arco651749/CNC-DESIGN/output/v11/ADJUSTMENT_DESIGN.md

# v11 調整機構設計

v10 已定版。v11 = v10 加上調整機構：每一項組裝時要校的幾何關係，模型裡都有對應的量測基準和可微調、可鎖定的機構。

- 模型：`output/v11/CNC_v11.FCStd`（由 `freecad/v11/01_v11_adjusters.py` 從 v10 產生）
- 干涉檢查：`output/v11/logs/v11_motion.txt`
- 3D 導覽頁：`output/v11/CNC_adjusters_v11.html`（可切換校正工具組裝上／拆下）
- 動作模擬：`output/v11/CNC_motion_v11.html`（生產狀態，工具組已拆下）
- 校正流程：`output/v11/ALIGNMENT_PROCEDURE.md`（取代 v10 的 `ALIGNMENT_PLAN.md`）

## 1. 架構：三層，依序調整

Z 方向的「垂直度」其實是四個角度：Z 行程的前後傾、左右傾，主軸軸線的前後傾、左右傾。逐層的誤差累積估算（一般級滑塊、研磨底板）四項都超過 100 µrad 的目標，所以四項都要能調。

| 層 | 調什麼 | 機構 | 螺絲轉 10° | 調好後 |
|---|---|---|---|---|
| 1 | Z 行程前後傾，**左右腳座分開** | 腳座前凸緣下墊研磨薄鋼片；後方 10 mm 支點稜；可拆頂高螺絲抬起換片 | 每 0.01 mm 墊片 53 µrad | 腳座凸緣對基準底板配鉸 Ø8 銷 |
| 1 | X ⊥ Y | 腳座前方頂推塊，M6×0.75 一推一拉，柱距 640 | 33 µrad（X 走 300 變 0.010） | 同上 |
| 2 | Z 行程左右傾 | 滑座分鞍板＋Z 板；Z 板下方 Ø10 樞軸銷，上方 M6×0.5 對頂，力臂 430 | 32 µrad | Z 板對鞍板配鉸 Ø6 銷 |
| 3 | 主軸前後傾 | 三點支撐夾座，上方 1:20 斜楔，M5×0.5，力臂 69 | 10 µrad | **不打銷** |
| 3 | 主軸左右傾 | Ø8 樞軸銷在支點線上，左側 1:15 側向斜楔，力臂 69 | 13 µrad | **不打銷** |

為什麼這樣分層：

- **兩支立柱傾角不同造成的扭曲只能在第 1 層修。** X 線軌下游的機構只能做固定量的修正，修不掉隨 X 位置變化的誤差，所以左右腳座必須能分開調。
- **調整順序 1 → 2 → 3，後一層不會動到前一層。**
- **前兩層和主軸無關，調好後打銷鎖死。第 3 層跟著主軸走，不打銷**：主軸外殼對旋轉軸心的歪斜每支不同，換主軸就重調第 3 層。之後維修只准動第 3 層，就不會有人用主軸去掩蓋 Z 行程的誤差。

## 2. 可拆的校正工具組

調整機構裡，只負責「推」的零件都做成用螺絲鎖上的模組：鎖緊、打銷之後拆下，留著給下一台用。本身在承重的零件留在機上。
多台機並行生產時，一套工具組就能輪流校所有機台。

| 層 | 留在機上（承重或定位） | 可拆的工具組模組 | 拆下後由什麼保持 |
|---|---|---|---|
| 1 腳座前後傾 | 墊片 | 頂高螺絲（抬起凸緣換墊片），左右各一 | 墊片＋前後壓緊螺絲＋定位銷 |
| 1 轉向 | — | 推拉塊＋推、拉螺絲，左右各一 | 腳座螺絲＋定位銷 |
| 2 Z 板 | 樞軸銷 | 頂推塊＋頂推螺絲，左右各一 | 6 顆夾緊螺絲＋定位銷 |
| 3 主軸前後傾 | 鋼條、上方斜楔對、碟形彈簧 | 斜楔驅動座＋M5×0.5 螺絲（T 形頭勾住滑塊） | 螺栓預壓下的斜楔 |
| 3 主軸左右傾 | 樞軸銷 | 側向斜楔模組、右側跟隨塊 | 3 顆螺栓夾緊的摩擦力（約為螺栓頭扭矩的 18 倍） |

- 模型裡這 33 個零件歸在 `09 Alignment kit` 群組，屬性 `Kit = removable`。
- 3D 導覽頁可以切換「校正工具組 裝上／拆下」；動作模擬頁顯示的是拆下後的生產狀態。
- 拆下後機上只留螺絲孔，之後要重調（例如換主軸、撞機後）再把模組裝回去。
- 拆模組時鬆開的是推力，不是夾緊力，理論上不會動到設定；流程中仍規定拆完要複量一次。

## 3. X 軸為什麼沒有獨立的調整機構

X 軸的幾何關係都由其他地方決定：

| X 軸的關係 | 由哪裡調 |
|---|---|
| 兩支 X 線軌互相平行 | X 底板上的靠銷、偏心銷 |
| X ⊥ Y | 腳座推拉（第 1 層） |
| 兩支立柱傾角不同造成的 X 滑座側傾 | 左右腳座墊片分開調（第 1 層） |
| X 行程左右高低 | 不必調：治具板由機台自銑，板面必然平行於 X 運動，Z 的左右傾也對這個面調 |
| X 螺桿對 X 線軌平行 | 沒有調整機構（Y、Z 軸相同），靠支撐座與螺帽座的螺絲孔間隙，組裝時把滑座移到兩端再鎖緊 |

螺桿平行度不影響路徑精度，只影響螺桿壽命和順暢度。

## 4. 第 3 層：主軸三點支撐夾座

這是本版的重點。v11 第一版是「耳朵上四支頂高螺絲頂開一條縫」，審查算出鎖緊時鋁耳會被壓彎（耳朵每 1 kN 彎約 0.1 mm，整個調整縫只有 0.085 mm），四個螺絲尖也過拘束，所以整個重做。

**結構**

| 零件 | 說明 |
|---|---|
| `Spindle_clamp` | 6061-T6，156×86×88，Ø65 H7 孔在 (x0, y−13)。後面與孔同一次裝夾加工，後壁 6.5 mm。前方開口，2 支 M6 夾緊 |
| `Spindle_bar` | C45 研磨鋼條 160×8×12，前面磨 R100 弧面（頂點 z327）＝前後傾支點線；中段讓空 0.3，只在兩側凸耳下接觸 |
| `Spindle_nod_wedge_base` / `Spindle_nod_wedge` | 1.2510 淬硬 1:20 斜楔對，在 (x50, z396)，滑塊前面 R100 弧面。M5×0.5 螺絲從上方帶動，行程 ±5 = ±3.6 mrad |
| `Spindle_roll_pin` | Ø8 m6 淬硬銷，壓入滑板 12 mm、伸入夾座 6 mm（鼓形端），在 (x50, z327)：左右傾樞軸，正好在支點線上、斜楔正下方 |
| `Spindle_roll_wedge` | 1:15 淬硬側向斜楔，弧面頂在夾座左側面 z396，M5×0.5 從上方帶動，行程 ±4 = ±3.9 mrad |
| `Spindle_follower_screw` | 右側 M6×0.5 銅頭螺絲，把夾座頂向側向斜楔 |
| `Spindle_bolt_1..3` + `Spindle_disc_springs_1..3` | 3 顆 M6×50 從前面鎖，各自正對它壓的支撐點（B1、B2 在鋼條上，B3 在斜楔上）。每顆下方 4 片並聯 DIN 2093 A14 碟形彈簧，6 Nm |

**設計要點**

- **全程線接觸或面接觸，沒有任何東西站在螺絲尖上。**
- **前後傾在螺栓鎖到最終扭力之後才調。** 碟形彈簧讓斜楔在鎖緊狀態下仍推得動，調完就不再鎖任何東西，所以沒有「鎖緊後跑掉」。這是業界常被提到的問題（鎖緊後校正值跑掉，跑掉量和扭力成正比）。
- **斜楔的摩擦力沿 Z 方向穿過樞軸銷**，調前後傾不會帶動左右傾。
- **鋁夾座和鋼滑板的熱脹差**（20 K 時約 28 µm）由弧面線接觸處滑動吸收，角度不受影響。
- **主軸軸線往前移 13 mm**，夾座才能離開滑板 8 mm、後壁加厚到 6.5 mm。治具板跟著往前 13 mm，刀尖仍能走遍整塊板。

**估算的性能（未實測）**

| 項目 | v11 第一版 | 本版 |
|---|---|---|
| 解析度（每 10°） | 82 / 87 µrad | 10 / 13 µrad |
| 刀尖受 100 N 變位 | 2–5 µm，鎖緊會壓垮 | 約 2.7 µm（接觸剛性不確定度約 ±50%） |
| 鎖緊後偏移 | 會 | 前後傾無；左右傾估計 ≤ 2 µrad |

## 5. 第 1 層：腳座墊片與轉向推拉

- 腳座底面只有後方 y167..177 一條 10 mm 寬的支點稜，其餘讓空 0.5 mm。後方兩顆 M6 鎖在支點稜上，不會把腳座壓彎。
- 前凸緣底下墊一疊研磨薄鋼片，標準厚度 0.5 mm。U 形開口朝前，鬆開壓緊螺絲就能繞著螺絲塞進、抽出，不必拆螺絲。
- 墊片到支點稜約 190 mm：0.01 mm 墊片 ≈ 53 µrad ≈ Z 走 100 mm 差 0.005 mm。可抽掉全部 0.5 mm 或再加，範圍約 ±2.6 mrad。
- **量完直接算**：墊片要變多厚（mm）＝ 該支立柱的前後傾（每 100 mm 讀值）× 1.9。讀值為正（Z 往前倒）就加，為負就抽。通常一到兩次就到位。
- 換墊片時用一支 M8×1 頂高螺絲旋入凸緣、頂在基準底板的銅墊上，把前端抬起約 1 mm。它屬於校正工具組，墊好就退出來。
- 選墊片而不選斜楔的理由：面接觸、剛性最好，是業界最常用的做法；機上不留可動件；腳座也省掉斜面座的加工。代價是解析度一步 0.005/100，剛好等於每站目標，所以 0.005 mm 的墊片也要備著。
- 轉向推拉塊一推一拉：修正過頭時不必去推另一隻腳，龍門不會每修一次就往後走。

## 6. 其他修正

| 項目 | 修正 |
|---|---|
| 線軌側壓螺絲 | 移到靠銷正對面。原本壓在兩支銷中間，估算 200 N 就把主軌壓彎約 7 µm |
| 偏心銷 | 加止付螺絲鎖定 |
| X 水平頂高座 | 拿掉，X 底板靠治具定位後鎖緊 |
| 錶座 | 拿掉 Z 滑板左下角的偏心錶座（它讓 X 左端量不到）。錶改夾在筒夾裡，跟主軸同軸 |
| 治具板 | 往前 13 mm；改成先銑一次當量測基準、最後再銑一刀 |

## 7. 相對 v10 改了哪些零件

| 零件 | v10 | v11 |
|---|---|---|
| 腳座 | 80×180，被立柱整個蓋住 | 80×230，前凸緣 50，底面支點稜，凸緣下墊片 |
| 滑座 | 一塊 t30 | Z 板 t18＋鞍板 t12，總厚度不變 |
| 主軸夾座 | 96×81×70，主軸在 y0 | 156×86×88，主軸在 y−13 |
| 主軸本體、筒夾、刀具 | y0 | 往前 13 mm |
| X 底板、Z 板、Z 滑板、工作台、基準底板 | — | 只加孔 |

基準底板只加了孔，沒有銑槽或台階。

## 8. 量產前要用原型驗證

這套主軸調整機構沒有現成先例可對照：業界前後傾幾乎都靠墊片。下面的數字目前都是估算。

1. **主軸外殼對旋轉軸心的歪斜**：量 5 到 10 支（外殼放 V 枕、筒夾夾檢驗棒、轉外殼看平均偏移）。這個數字決定斜楔行程；目前用 0.05／100 估，設計 ±3.6 mrad 已留餘裕。可同時當進料驗收標準。
2. 刀尖剛性：100 N 對照「夾座直接鎖死」的基準，目標約 2.7 µm。
3. 鎖緊偏移：三種鎖緊順序各 10 次。
4. 反向空程：斜楔反向時估約 8 µrad。
5. 熱循環 20 次（冷機到 24k rpm 運轉 2 小時）後的漂移，並檢查接觸處有無磨損。
6. 撞機：0.5 kN、1 kN 推力；約 2 kN 以上夾座會在左右方向滑動，需要重調。
7. 三位沒受過訓練的技師計時，目標完整校正第 3 層 15 分鐘內。

## 9. 還沒做的

- v11 的應力應變分析（腳座支點稜加斜楔、滑座分兩片、新夾座）。
- 線軌與滑塊的一般鎖附螺絲孔（仍是設計評估階段）。
- 以 v11 的實際機構重做調校動畫。
