arco651749/CNC-DESIGN/output/v11/ALIGNMENT_PROCEDURE.md

# v11 校正流程

適用：`output/v11/CNC_v11.FCStd`。機構說明見 `output/v11/ADJUSTMENT_DESIGN.md`。
本文件取代 v10 的 `output/v10/ALIGNMENT_PLAN.md`，並修正獨立審查指出的問題：治具板太晚銑、偏心錶座讓 X 左端量不到、
檢驗棒行程不夠、鋁治具板吸不住磁性錶座、側壓螺絲壓彎主軌、翻轉法正負號未定義。

## 0. 原則

1. **錶永遠裝在主軸中心線上**：錶桿夾在 ER11 筒夾裡（Ø6 桿的槓桿錶座），錶跟著主軸走，X、Y 全行程都量得到。
2. **所有垂直度都對「銑過的治具板面」量。** 治具板是機台自己銑的，板面就是 X-Y 運動平面。
3. **治具板銑兩次**：龍門一鎖上就先銑一次當基準（銑削時 Z 固定、只走 X-Y，結果和龍門傾斜無關）；第 1、2 層調完再銑最後一刀。
4. **三層依序調：龍門腳座 → Z 板 → 主軸夾座。** 後一層不會動到前一層。前兩層調好打銷；主軸夾座不打銷。
5. 治具板是鋁的，磁性錶座吸不住。需要錶座固定在工作台時，用 T 槽壓板夾住錶座，或把治具板拆下吸在鋼工作台上。
6. 每個量測值都記在第 9 節的紀錄表。
7. **只負責推的零件是可拆的校正工具組**：每一層鎖緊、打銷、複量合格後拆下，拆完再量一次；工具組留給下一台用。

### 翻轉法的正負號

讀值定義：走完量測長度 L 後的讀值減起點讀值，錶被壓進去為正，再除以 L，得到斜率 m。
基準件在位置 1 量得 m1，翻轉 180° 後量得 m2，兩次都走同一方向：

- 機台誤差 = (m1 + m2) / 2
- 基準件誤差 = (m1 − m2) / 2

花崗石直角尺：沿 A 邊翻面，重新把 A 邊對齊 Y，再讀 B 邊。圓柱直角尺：繞自己的軸轉 180°，從同一側讀。

## 1. 工具

| 工具 | 規格 | 用途 |
|---|---|---|
| 槓桿式千分錶 2 支 | 0.001–0.002 mm | 所有量測 |
| 筒夾錶座 | Ø6 桿，夾在 ER11，錶尖可調到距軸心 100 mm | 錶裝在主軸中心線上 |
| 花崗石直角尺 | 300×200 以上，00 級 | X ⊥ Y |
| 圓柱直角尺 | Ø80×150，00 級 | Z 行程前後、左右傾 |
| 花崗石平尺 | 500 mm | 主軌直線度（必檢） |
| 跨橋量具（自製） | 鋼塊騎在主軌上，錶碰副軌 | 兩軌平行 |
| ER11 檢驗棒 | Ø6–7，露出約 80 mm | 主軸偏擺、最終閉合檢查 |
| V 枕一對 | — | 主軸進料檢驗 |
| 扭力扳手 | 1–10 N·m 及 M8 範圍 | 定扭力鎖附 |
| 長柄六角扳手 | 2.5 mm（M5 斜楔螺絲） | 小角度微調 |
| 研磨薄鋼片 | 0.005、0.01、0.02、0.05、0.1、0.3 mm，U 形開口 | 腳座前後傾 |
| 手提鉸刀與鑽模襯套 | Ø6、Ø8 H7 | 配鉸定位銷 |
| 花崗石平台 | 至少 800×500 | 龍門次組立（龍門寬 720，630 的平台放不下）；沒有的話龍門直接在機台上組 |

驗收時建議租用循圓測試儀，或用試切件送三次元。

## 2. 進料檢驗

1. 立柱兩端面：銑削，對側面垂直度 ≤ 0.02/160。
2. **主軸外殼對旋轉軸心**：外殼放 V 枕，筒夾夾檢驗棒，千分錶碰檢驗棒的近端和遠端；轉動整支外殼一圈，記下兩點的平均偏移，兩者之差除以距離就是夾角。前 5–10 支的結果用來確認斜楔行程，之後當驗收標準。
3. 夾座：Ø65 孔與後面的垂直度、夾座後面平面度。

## 3. 組裝與線軌（零件平放時做）

每支線軌都一樣：

1. 主軌靠 3 支靠銷，正對靠銷的側壓螺絲壓住；螺絲由中間往兩端、分兩輪鎖到定扭力。
2. **主軌直線度（必檢）**：平尺放在主軌旁，或錶沿主軌側面滑全長，≤ 0.005。超差先查靠銷與側壓螺絲，不要往下做。
3. 副軌輕鎖。跨橋量具騎在主軌上，錶碰副軌側面，滑全長；轉偏心銷到讀值變化 ≤ 0.005，鎖緊副軌，偏心銷用止付螺絲鎖住。
4. 裝螺桿：螺帽座移到靠近固定側支撐座的位置再鎖緊；全行程看伺服負載率是否平穩。

順序：

- X 線軌在 X 底板上機之前裝好。
- **Z 線軌在裝 Z 滑板之前調好**：裝上滑板後，部分偏心銷和側壓螺絲會被蓋住。
- Y 線軌在工作台底面，工作台翻面時做。
- Y 滑塊：主側兩顆靠基準底板上的靠銷鎖緊，副側兩顆浮動；裝上工作台，手推全行程數次，在行程中段鎖緊副側。

## 4. 龍門上機與治具板第一次銑削

1. 腳座先鎖在立柱底端，X 底板用治具定位在兩支立柱背面並鎖緊。
2. 龍門放上基準底板。兩個腳座凸緣下先墊標準厚度 0.5 mm 的墊片，腳座螺絲上到貼合即可。
3. 鎖上治具板（比 v10 往前 13 mm）。
4. **第一次銑削**：機台把治具板輕銑一刀，0.1 mm。

## 5. 第 1 層：龍門腳座

### 5.1 X ⊥ Y（轉向）

1. 直角尺平放在治具板上。
2. 錶碰 A 邊，走 Y；輕敲直角尺到全程讀值不變。
3. 錶改碰 B 邊，走 X 280 mm，記下 m1。
4. 直角尺翻面，重做 2、3，記下 m2。機台誤差 = (m1 + m2)/2。
5. 鬆開腳座的壓緊螺絲，用腳座前方的推拉螺絲一退一進，把一支立柱往前或往後移。螺絲轉 10°，X 走 300 mm 約變 0.010 mm。
6. 目標 ≤ 0.010/300。

### 5.2 Z 行程前後傾（左右腳座分開）

1. 圓柱直角尺立在治具板上，錶從筒夾伸出約 100 mm，碰圓柱朝後的一面。
2. X = −150 時走 Z 100 mm，讀值 e₋；X = +150 時再走一次，讀值 e₊。
3. 兩支立柱的傾角（每 100 mm）：
   - 左柱 L = (0.734·e₋ − 0.266·e₊) / 0.468
   - 右柱 R = (0.734·e₊ − 0.266·e₋) / 0.468

   推導：立柱在 x = ±320，X = −150 處的傾斜是兩柱的線性內插，e₋ = 0.734·L + 0.266·R；X = +150 處 e₊ = 0.266·L + 0.734·R。
4. **算墊片**：墊片要變多厚（mm）＝ 該柱傾角（每 100 mm 讀值）× 1.9。讀值為正代表 Z 往前倒（往上走時錶被壓進去），要加墊片；為負就抽掉。例：L = +0.008/100 → 左腳座加 0.015 mm。
   1.9 是墊片位置到後方支點稜的距離（約 190 mm）除以 100；0.01 mm 墊片約 0.005/100。
5. **換墊片**：鬆開該腳座**後方支點稜上的兩顆 M6** 和前方壓緊螺絲，頂高螺絲旋入凸緣把前端抬起約 1 mm，換墊片，退出頂高螺絲，依序鎖回。
6. 重量 e₋、e₊。通常一到兩次就到位。
7. 目標：兩站各 ≤ 0.005/100，**兩站之差 ≤ 0.005/100**。兩站之差代表兩支立柱傾角不同，會扭 X 底板，造成滑座側傾。

### 5.3 鎖緊、複量、打銷

1. 依序鎖緊：後方支點稜 M6 → 前方壓緊 M8 → 推拉螺絲對鎖。
2. 重做 5.1、5.2。鎖緊常會讓數值跑掉，合格值必須是鎖緊後量到的。
3. 合格後，兩個腳座凸緣各與基準底板配鉸一支 Ø8 定位銷。
4. 打銷後再量一次並記錄。
5. 拆下工具組：兩個推拉塊（連同推、拉螺絲）。頂高螺絲在換完墊片時就已退出。墊片留在原位。拆完重做 5.1、5.2 一次，確認沒有變化。

## 6. 第 2 層：Z 板（Z 行程左右傾）

1. 圓柱直角尺立在治具板上，錶碰圓柱的側面，走 Z 100 mm，讀值記 m1；圓柱轉 180° 再量 m2，取 (m1 + m2)/2。
2. 鬆開 Z 板的 6 顆夾緊螺絲，鞍板上兩支頂推螺絲一退一進，Z 板繞下方樞軸銷轉動。螺絲轉 10° 約變 0.003/100。
3. 目標 ≤ 0.005/100（上限 0.010）。
4. 鎖緊夾緊螺絲，兩支頂推螺絲對鎖，複量。合格後 Z 板與鞍板配鉸一支 Ø6 定位銷，再量一次並記錄。
5. 拆下兩側的頂推塊（連同螺絲），再量一次。

### 治具板最後一刀

第 1 層的調整改變了 X 運動平面，所以在進入第 3 層之前，治具板再銑一刀。

## 7. 第 3 層：主軸夾座

量法：錶桿夾在筒夾裡，錶尖距軸心 100 mm，碰治具板。手轉主軸，在前、後、左、右四點讀值。

- 前後傾 = (前 − 後) / 200
- 左右傾 = (左 − 右) / 200
- 目標：兩方向的讀值差各 ≤ 0.010（等於 50 µrad）。0.002 的錶可分辨約 10 µrad。

步驟：

1. 主軸夾緊螺絲先鎖到固定扭力。夾緊力不均會改變主軸角度，所以一定要在調整前夾好。
2. 兩個斜楔放在中間刻線；夾座掛上樞軸銷，3 顆螺栓鎖到 1 N·m。
3. 掃四點，記錄。
4. **左右傾**：右側跟隨螺絲退 1/4 圈，轉左側側向斜楔的螺絲（每 10° 約 13 µrad）。要往反方向修時，先用跟隨螺絲推過頭，再用斜楔推回來，讓最後一步永遠是「斜楔推進」。跟隨螺絲靠上，0.3 N·m。
5. 3 顆螺栓鎖到最終的 6 N·m。
6. **前後傾**：在最終扭力下直接轉上方斜楔螺絲（每 10° 約 10 µrad；一圈約讓前後讀值差變 0.072）。碟形彈簧會跟著，不必鬆螺栓。最後一步要往「斜楔推進」的方向結束。
7. 重掃四點並記錄。
8. 拆下工具組：左側側向斜楔模組、右側跟隨塊、上方斜楔的驅動座（連同螺絲）。上方斜楔對留在原位。拆完重掃四點，確認沒有變化。
9. 之後若因任何原因重鎖螺栓，就要把工具組裝回去重調。

**換主軸時只重做本節**：裝回主軸那一組工具組，調完再拆。前兩層不用動。目標 15 分鐘內完成。

## 8. 驗收

1. **扭曲檢查**：X = −150 與 +150 各做一次前後掃描，兩者之差 ≤ 0.010。
2. **閉合檢查**：拆下治具板。檢驗棒露出 80 mm，錶座用 T 槽壓板固定在工作台上，錶碰檢驗棒，走 Z 60 mm（裸台時刀尖到台面約有 62 mm 行程）。X 向、Y 向各一次，每次主軸轉 180° 再量一次取平均，扣掉檢驗棒本身的偏擺。讀值是「主軸軸線與 Z 行程」的夾角，目標 ≤ 0.006/60，並應和第 5–7 節的結果吻合。
3. 重複定位：錶頂住擋塊，同方向靠近 10 次，散佈 ≤ 0.005；再量反向靠近的差值（背隙）。
4. 循圓測試或試切件。

這一步可以看出有沒有人用主軸層去掩蓋 Z 行程的誤差：掃描會好看，但閉合檢查會不合格。

## 9. 紀錄表

| 項目 | 量測長度 | 目標 (mm) | 實測 | 判定 |
|---|---|---|---|---|
| 主軌直線度（X/Y/Z） | 全長 | 0.005 | | |
| 兩軌平行（X/Y/Z） | 全長 | 0.005 | | |
| X ⊥ Y（翻轉平均） | 280 | 0.010/300 | | |
| Z 前後傾，X = −150 / +150 | 100 | 0.005 | | |
| 兩站之差 | 100 | 0.005 | | |
| Z 左右傾（翻轉平均） | 100 | 0.005（上限 0.010） | | |
| 主軸掃描，前後 / 左右 | R100 | 0.010 | | |
| 扭曲檢查（X = ±150 前後掃描之差） | R100 | 0.010 | | |
| 閉合檢查（X 向 / Y 向） | 60 | 0.006 | | |
| 重複定位（X/Y/Z） | — | 0.005 | | |
| 背隙（X/Y/Z） | — | 記錄 | | |
| 主軸外殼對軸心（進料） | — | 待定 | | |
| 循圓或試切件 | — | 記錄 | | |

目標值是把 ±0.02 mm 的路徑精度大約留一半給幾何誤差所推出來的建議值，首台實測後可以再調整。
