arco651749/CNC-DESIGN/output/v4/V4_NOTES.md

# v4 設計（由 v3 r7 衍生，r7 定稿不動）

產生：`freecadcmd freecad/v4/01_v4_through_slot_x.py`（讀 `output/v3/CNC_v3_r7.FCStd` → `output/v4/CNC_v4.FCStd`），
檢查：`freecadcmd freecad/v4/02_motion_check_v4.py` → `output/v4/logs/v4_motion.txt`（靜態全零件兩兩比對＋18 姿態：無碰撞）、`v4_clear.txt`。

## 與 r7 的差異
- **X 軸穿槽傳動**：X 螺桿、螺帽、C-TEK12、馬達都在 X 底板**後面**；底板開長槽 347×60，**螺帽座（CNC 塊）包住滾珠螺帽本體、外形同法蘭寬（52）**，法蘭鎖在螺帽座端面，螺帽座穿過長槽鎖到前面 X 滑座背面。前面只有 X 線軌。
- **X 底板 t20（720×160）當龍門橫樑**，鎖在兩支立柱的**後面**（整面鎖附）；取消鋁擠橫樑 ×2 與接合板。
- **X 滑座直接鎖滑塊**，取消 30 mm 墊條；X 線軌改 SX2RNL28-540（放進兩柱之間），主軸位置不變。
- **立柱前移**到 y 2–162（前緣到後排 Y 滑塊），間距 ±280（避開 X 滑座掃過 ±270），HFS8-80160-472。
- **X 馬達直結**（CPJC40 聯軸器）：馬達在螺桿延長線上、底板後面。軸心離底板 25、馬達半寬 30，所以底板後面在馬達段銑 **7 mm 定位凹槽**，Z 式馬達座嵌入凹槽、4×M6 鎖附（與 C-TEK12 同一面）。機寬約 768。
- **X 螺桿** C-KBS1505-395（固定－自由，軸心在底板後 25）。
- **基準板 t20、720×327**（r7：t30、640×512）。
- **驅動器**移到 X 底板後方的電控板（兩支撐柱，避開螺帽行程）。
- **三軸螺帽座都是包住螺帽的 CNC 塊**（外形同法蘭寬，法蘭鎖在端面）：X 穿過長槽鎖 X 滑座背面；Y 底面鎖基準板（Y 螺帽往後 26，讓座子完整落在基準板上）；Z 鎖主軸滑板背面。
- **三軸馬達座都挖 Ø50 H7 通孔**＝HG-KR43／43B 止口 Ø50×3（由三菱原廠 STEP 量得），馬達止口插入對心，聯軸器 Ø40 從同一孔穿過；取消原本 Ø44 孔＋Ø50 淺沉孔的兩段式做法。
- **三支螺桿端部加工**：螺紋 Ø16 直到 C-TEK12 端面 → Ø12×36（軸承＋鎖緊螺帽，在支撐座內）→ Ø10×27（插聯軸器 24.5，聯軸器 CPJC40-RD-10-14）。取消 v3 沿用的獨立「假軸頸」。
  - Y：C-KBS1505-538（螺紋 −305～170），X：C-KBS1505-458，Z：C-KBS1505-393。
  - 螺帽全行程都在螺紋上：Y 上料位置餘量 23、送入端 10；X 兩端 24／29。（修正：上一版 Y 上料時螺帽會跑出螺紋 29 mm；r7 也有 3 mm 跑出，r7 定稿未改。）
- Y、Z 其餘同 r7。

## 間隙（`v4_clear.txt`）
X 滑座↔立柱 10、螺帽座↔長槽 4、馬達↔凹槽底 2、工作台↔立柱 60、Y 馬達↔基準板 15、工作台↔Y 螺帽座 2.4、Z 螺帽座↔X 滑座 2.4。

## 待確認
- t20 底板開槽後的剛性（FEA）、長槽擋屑（不鏽鋼擋屑帶／伸縮護罩）。
- 電控板固定方式。
