arco651749/CNC-DESIGN/output/v3/R7_FINAL.md

# v3 → r7 修改紀錄（r7 定稿 2026-11-13）

**r7（最新）**：拿掉 X 軸浮動支撐座 C-TEF12，三軸螺桿都改成固定－自由。X 危險轉速（Ø15、L≈450）約 2100 rpm，打 8 折約 1680 rpm，大於 100 mm/s 所需的 1200 rpm。`freecad/revisions/08_r7_remove_x_float_support.py` → `output/v3/CNC_v3_r7.FCStd`、`output/v3/CNC_motion_r7.html`。
Y 軸前方那組是**固定滾珠螺帽＋螺帽座**（倒裝螺桿的驅動點），不是支撐座，保留。

由 `freecad/revisions/01..07` 從 `output/v3/CNC_v3.FCStd` 依序產生（`bash freecad/revisions/run_all.sh`）。
r6 重跑結果與互動修改版一致；三軸行程兩端＋中間 18 個姿態干涉檢查：無碰撞（`output/v3/logs/r6_motion.txt`）。

## 設計原則
- 馬達座、支撐座（C-TEK12）、線軌鎖在**同一個基準面**（單面加工、單面鎖附）。
- 三軸馬達座同一種做法：方塊加厚到支撐座旁，鎖在該軸基準面；軸心離基準面只有 25 mm（C-TEK12 中心高），
  60 方馬達靠基準面那側的兩顆螺孔落在面上，所以方塊帶一道**後唇**承接（Z 搭滑座板頂面、X 靠 X 軌板端面、Y 貼工作台後端面）。
- 螺桿端聯軸器露在座外；馬達端聯軸器先鎖在馬達軸上，再整組從 Ø44 孔插入。

## 各軸
| 軸 | 馬達座鎖在 | 後唇靠 | 同一面上的零件 |
|---|---|---|---|
| Z | 滑座板正面（4×M6 由前往後） | 滑座板頂面 | Z 線軌、C-TEK12 |
| X | X 軌板正面（4×M6 由前往後） | X 軌板端面 | X 線軌、C-TEK12 |
| Y | 工作台底面（4×M6 由下往上） | 工作台後端面 | C-HLG45 滑軌、C-TEK12 |

## BOM 變更（相對 v3）
| 項目 | v3 | r6 |
|---|---|---|
| Y 線軌 | SE2RZ42-680 ＋ 墊高條 t16 ×2 | **三住 C-HLG45**（H=70）滑軌 L700 ×2、滑塊 ×4，取消墊高條 |
| 工作台 | 440×420×40 | **440×473.5×40**（後端加長 53.5） |
| 龍門立柱 | HFS8-80160-300 | **HFS8-80160-312**（Y 墊高 12，淨空不變） |
| X 螺桿 | C-KBS1505-540 | **C-KBS1505-517.5**（支撐座內移 22.5） |
| X 滑座板 | 240×380×30 | **240×438×30**，整組 Z 軸上移 100 |
| 基準板 | 690×595×30 | **640×512×30** |
| 馬達座 | X/Y/Z 原支架 | X/Y/Z 方塊（自製），Y 馬達座跟著工作台移動 |
| Y 螺帽座 | 高 54 | 高 66 |
| X 浮動支撐座 | C-TEF12 | **取消**（r7，固定－自由） |

## 尺寸
- 機寬 775（v3 798）；Z 軸底座底部 z272（離工作台面 162）；Z 馬達頂 z861。
- Y 馬達底部離基準板 15 mm；滑塊離軌道末端 10.5 mm（Y 兩端）。

## 待辦
- HFS8-80160-312、C-KBS1505-517.5 目前由舊長度模型接長／截短，待換原廠 STEP。
- 主軸懸伸增加 100（Z 軸上移），刀尖剛性待 FEA 確認。
- C-HLG45 滑塊螺孔朝下：先把滑塊鎖到基準板，再裝上床身。

## 檔案
- `output/v3/CNC_v3_r6.FCStd`：r6 組立（r2–r5、`_fix` 為中間版）
- `output/v3/CNC_motion_r6.html`：3D 動作模擬（單檔、可離線開）
- `output/v3/r6_renders/`：特寫圖
