arco651749/CNC-DESIGN/output/CNC_Gantry.step

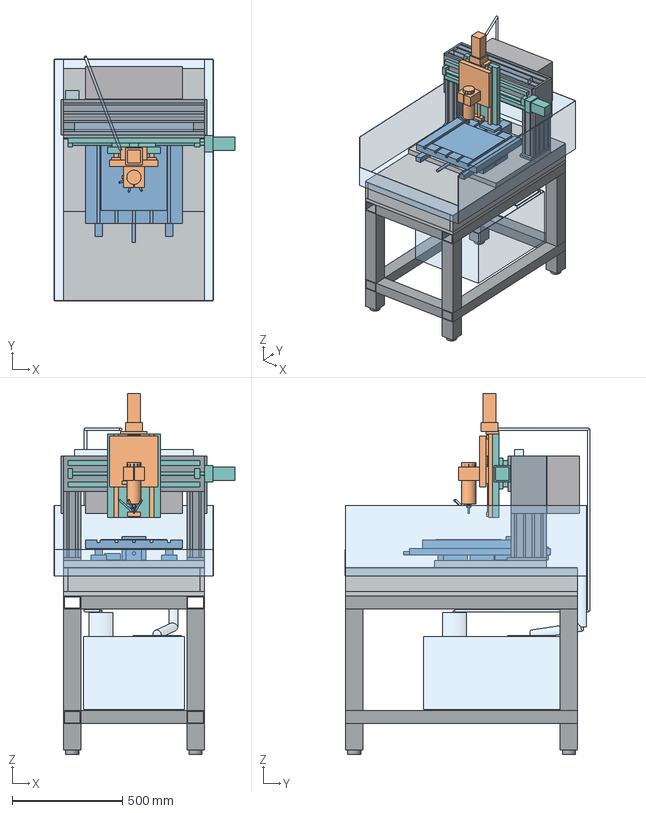
[picture p1: CAD file, 2026-11-12]
output/CNC_Gantry.step
820.1 x 1113.0 x 1639.0 mm
Stand_leg_1
Stand_leg_2
Stand_leg_3
Stand_leg_4
Stand_top_L
Stand_top_R
Stand_top_F
Stand_top_B
Stand_low_L
Stand_low_R
Stand_low_F
Stand_low_B
Leveling_foot_1
Leveling_foot_2
Leveling_foot_3
Leveling_foot_4
Datum_base_plate
Bed_floor_sheet
Bed_bottom_plate
Bed_long_web_1
Bed_long_web_2
Bed_long_web_3
Bed_long_web_4
Bed_cross_rib_1
Bed_cross_rib_2
Bed_cross_rib_3
Bed_cross_rib_4
Bed_cross_rib_5
Y_rail_L
Y_block_L1
Y_block_L2
Y_rail_R
Y_block_R1
Y_block_R2
Y_ballscrew
Y_nut_housing
Y_motor_bracket
Y_motor_adapter
Y_coupling
Y_motor
Y_drag_chain
Work_table
Work_area_300x300
Column_foot_L
Gantry_column_L
Gantry_joint_plate_L
Column_foot_R
Gantry_column_R
Gantry_joint_plate_R
Gantry_beam_1
Gantry_beam_2
X_rail_plate
X_rail_1
X_block_11
X_block_12
X_rail_2
X_block_21
X_block_22
X_ballscrew
X_BK_support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
