arco651749/CNC-DESIGN/output/core/CNC_Core.step

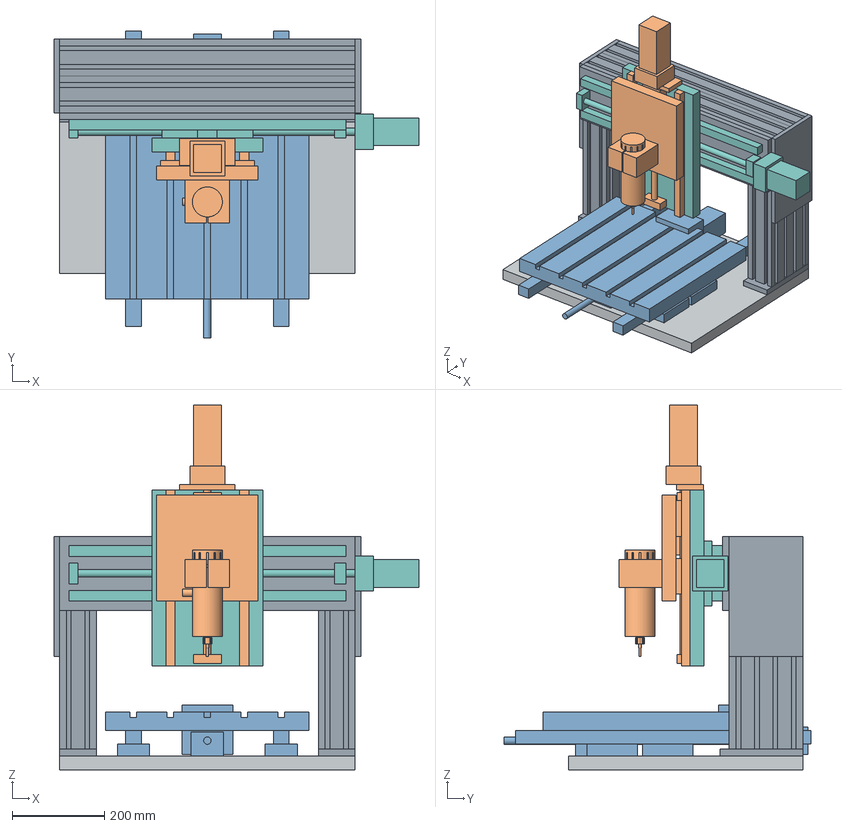
[picture p2: CAD file, 2026-11-12]
output/core/CNC_Core.step
790.0 x 665.5 x 789.0 mm
Datum_base_plate
Y_rail_L
Y_block_L1
Y_block_L2
Y_rail_R
Y_block_R1
Y_block_R2
Y_ballscrew
Y_nut_housing
Y_motor_bracket
Y_motor_adapter
Y_coupling
Y_motor
Work_table
Column_foot_L
Gantry_column_L
Gantry_joint_plate_L
Column_foot_R
Gantry_column_R
Gantry_joint_plate_R
Gantry_beam_1
Gantry_beam_2
X_rail_plate
X_rail_1
X_block_11
X_block_12
X_rail_2
X_block_21
X_block_22
X_ballscrew
X_BK_support
X_BF_support
X_motor_mount
X_coupling
X_motor
X_carriage_plate
X_nut_housing
Z_rail_L
Z_rail_R
Z_slide_plate
Z_block_L1
Z_block_L2
Z_block_R1
Z_block_R2
Z_ballscrew
Z_nut_housing
Z_BF_support
Z_BK_support
Z_motor_base
Z_motor_mount
Z_coupling
Z_motor
Spindle
Spindle_fan_cover
Spindle_connector
Spindle_nose
ER11_collet
ER11_nut
Tool_D5
Spindle_clamp
