arco651749/CNC-DESIGN/output/v1/CNC_Gantry_v1.FCStd

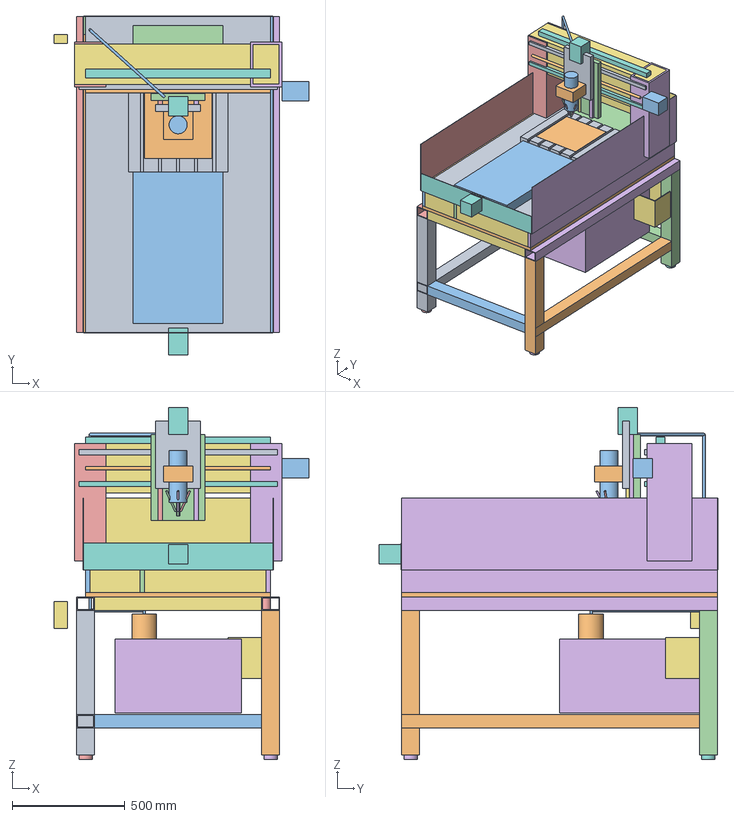
[picture p3: CAD file, 2026-11-12, an earlier design]
output/v1/CNC_Gantry_v1.FCStd
1130.0 x 1502.0 x 1560.0 mm
Stand_leg_1
Stand_leg_2
Stand_leg_3
Stand_leg_4
Stand_top_L
Stand_top_R
Stand_top_F
Stand_top_B
Stand_low_L
Stand_low_R
Stand_low_F
Stand_low_B
Leveling_foot_1
Leveling_foot_2
Leveling_foot_3
Leveling_foot_4
Bed_top_plate
Bed_bottom_plate
Bed_long_web_1
Bed_long_web_2
Bed_long_web_3
Bed_long_web_4
Bed_cross_rib_1
Bed_cross_rib_2
Bed_cross_rib_3
Bed_cross_rib_4
Bed_cross_rib_5
Bed_cross_rib_6
Bed_cross_rib_7
Y_rail_L
Y_block_L1
Y_block_L2
Y_rail_R
Y_block_R1
Y_block_R2
Y_ballscrew
Y_nut_housing
Y_BK_support
Y_BF_support
Y_motor
Work_table
Work_area_300x300
Y_bellows_front
Y_bellows_rear
Gantry_column_L
Gantry_column_R
Gantry_beam
X_rail_1
X_rail_2
X_ballscrew
X_motor
X_carriage_plate
Z_rail_L
Z_rail_R
Z_ballscrew
Z_motor
Z_slide_plate
Spindle_clamp
Spindle
Tool_ER20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
