arco651749/CNC-DESIGN/output/v10/fea/x_base_plate.step

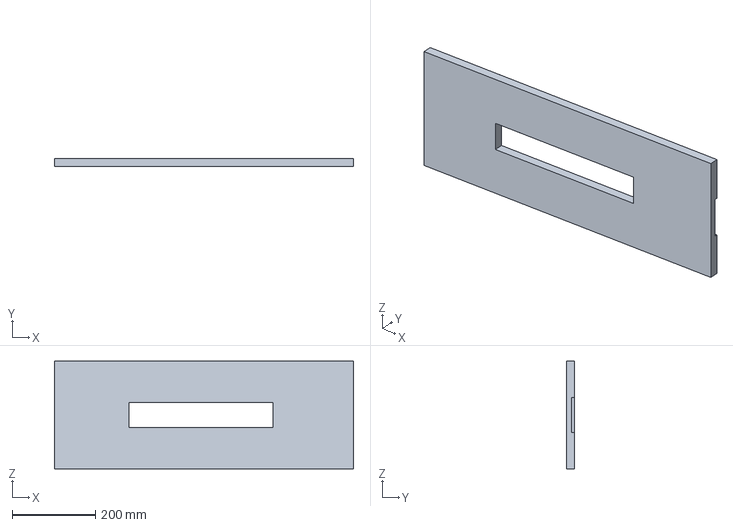
[picture p4: CAD file, 2026-11-13, an earlier design]
output/v10/fea/x_base_plate.step
720.0 x 20.0 x 260.0 mm
