arco651749/CNC-DESIGN/output/v3/CNC_v3-AP214.step

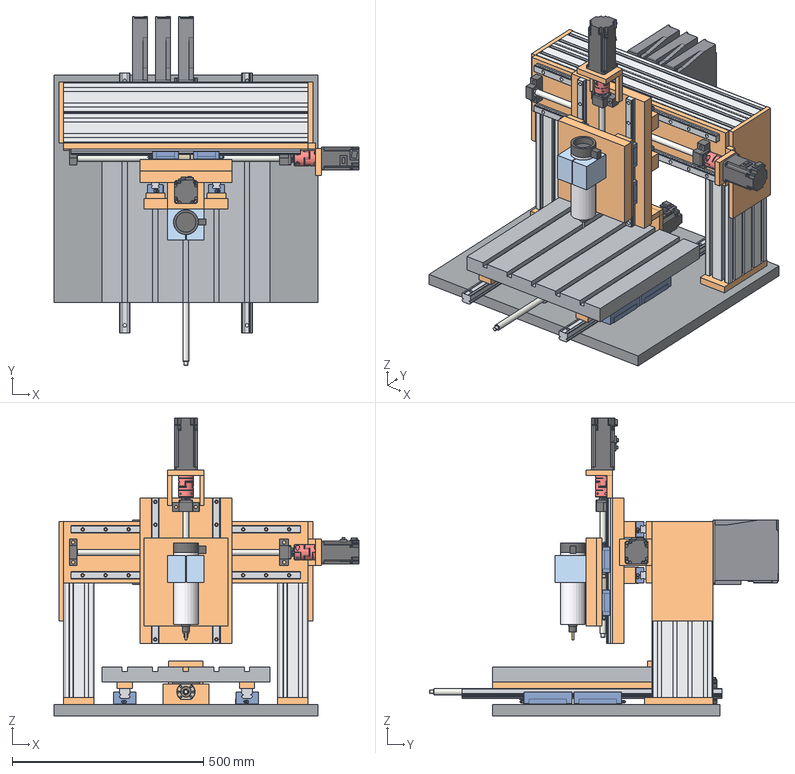
[picture p5: CAD file, 2026-11-13, an earlier design]
output/v3/CNC_v3-AP214.step
797.8 x 913.2 x 779.1 mm
Datum_base_plate
Y_rail_L
Y_block_L1
Y_block_L2
Y_carrier_bar_L
Y_rail_R
Y_block_R1
Y_block_R2
Y_carrier_bar_R
Work_table
Y_ballscrew
Y_ball_nut
Y_nut_bracket
Y_support_fixed
Y_journal
Y_coupling
Y_motor
Y_motor_bracket
Column_foot_L
Gantry_column_L
Gantry_joint_plate_L
Column_foot_R
Gantry_column_R
Gantry_joint_plate_R
Gantry_beam_1
Gantry_beam_2
X_rail_plate
X_rail_1
X_block_11
X_block_12
X_spacer_1
X_rail_2
X_block_21
X_block_22
X_spacer_2
X_carriage_plate
X_ballscrew
X_ball_nut
X_nut_bracket
X_support_fixed
X_support_float
X_journal
X_coupling
X_motor
X_motor_bracket
Z_rail_L
Z_block_L1
Z_block_L2
Z_spacer_L
Z_rail_R
Z_block_R1
Z_block_R2
Z_spacer_R
Z_slide_plate
Z_ballscrew
Z_ball_nut
Z_support_fixed
Z_journal
Z_coupling
Z_motor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
