arco651749/CNC-DESIGN/output/v4/CNC_v4.FCStd

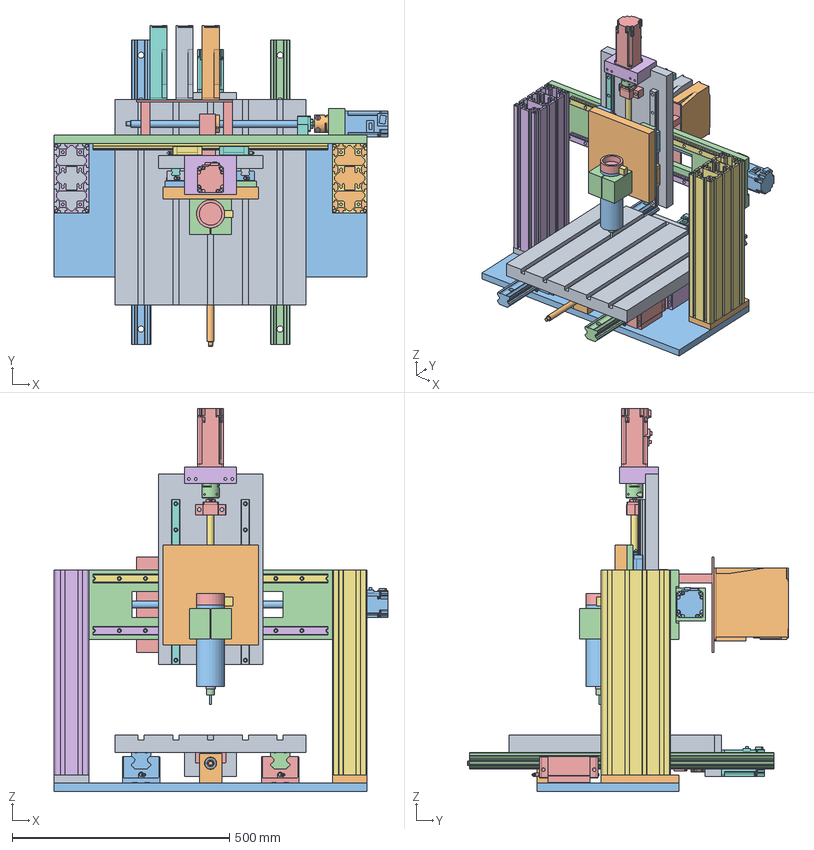
[picture p6: CAD file, 2026-11-13, an earlier design]
output/v4/CNC_v4.FCStd
767.8 x 738.2 x 881.1 mm
Column_foot_L
Column_foot_R
Datum_base_plate
ER11_nut
Electrical_panel
Gantry_column_L
Gantry_column_R
Servo_amp_X
Servo_amp_Y
Servo_amp_Z
Spindle_body
Spindle_clamp
Spindle_fan_cover
Spindle_nose
Spindle_plug
Tool_D5
Work_table
X_ball_nut
X_ballscrew
X_base_plate
X_block_11
X_block_12
X_block_21
X_block_22
X_carriage_plate
X_coupling
X_motor
X_motor_block
X_nut_bracket
X_rail_1
X_rail_2
X_support_fixed
Y_ball_nut
Y_ballscrew
Y_block_L1
Y_block_L2
Y_block_R1
Y_block_R2
Y_coupling
Y_motor
Y_motor_block
Y_nut_bracket
Y_rail_L
Y_rail_R
Y_support_fixed
Z_ball_nut
Z_ballscrew
Z_block_L1
Z_block_L2
Z_block_R1
Z_block_R2
Z_coupling
Z_motor
Z_motor_plate
Z_nut_housing
Z_rail_L
Z_rail_R
Z_slide_plate
Z_spacer_L
Z_spacer_R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
