arco651749/CNC-DESIGN/output/v4/fea/x_base_plate.step

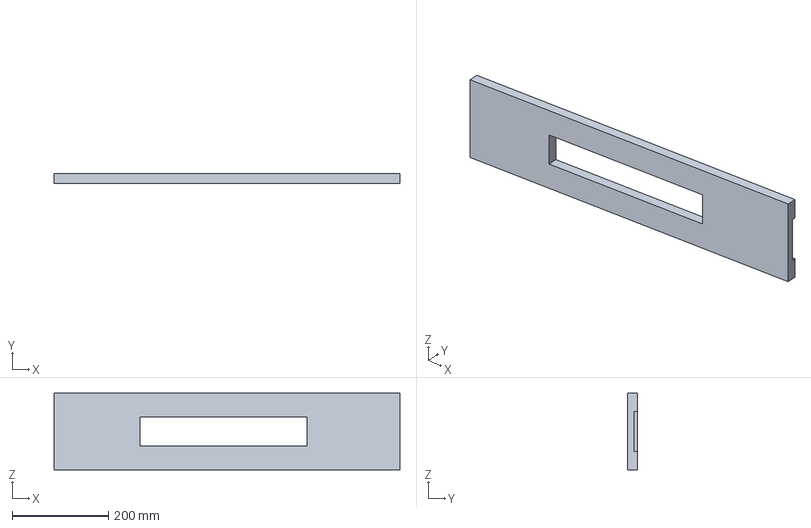
[picture p7: CAD file, 2026-11-13, an earlier design]
output/v4/fea/x_base_plate.step
720.0 x 20.0 x 160.0 mm
