arco651749/CNC-DESIGN/output/v3/CNC_v3_r2.FCStd

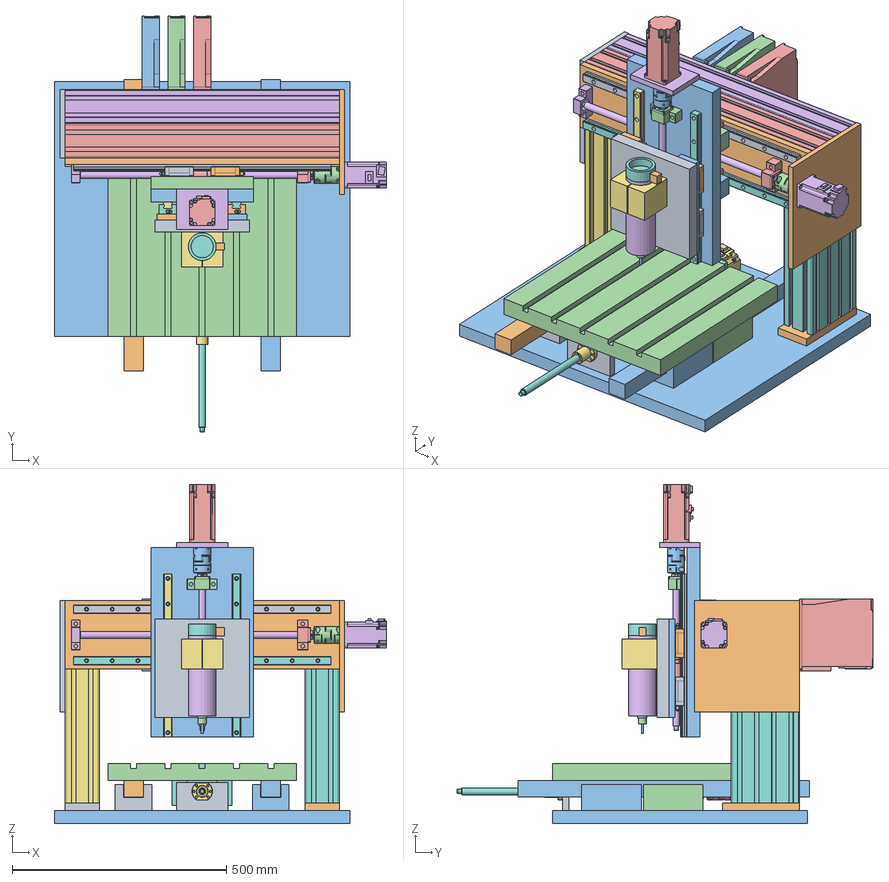
[picture p10: CAD file, 2026-11-13, an earlier design]
output/v3/CNC_v3_r2.FCStd
775.3 x 970.7 x 791.1 mm
Column_foot_L
Column_foot_R
Datum_base_plate
ER11_nut
Gantry_beam_1
Gantry_beam_2
Gantry_column_L
Gantry_column_R
Gantry_joint_plate_L
Gantry_joint_plate_R
Servo_amp_X
Servo_amp_Y
Servo_amp_Z
Spindle_body
Spindle_clamp
Spindle_fan_cover
Spindle_nose
Spindle_plug
Tool_D5
Work_table
X_ball_nut
X_ballscrew
X_block_11
X_block_12
X_block_21
X_block_22
X_carriage_plate
X_coupling
X_journal
X_motor
X_nut_bracket
X_rail_1
X_rail_2
X_rail_plate
X_spacer_1
X_spacer_2
X_support_fixed
X_support_float
Y_ball_nut
Y_ballscrew
Y_block_L1
Y_block_L2
Y_block_R1
Y_block_R2
Y_coupling
Y_journal
Y_motor
Y_motor_plate
Y_nut_bracket
Y_rail_L
Y_rail_R
Y_support_fixed
Z_ball_nut
Z_ballscrew
Z_block_L1
Z_block_L2
Z_block_R1
Z_block_R2
Z_coupling
Z_journal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
