arco651749/CNC-DESIGN/(list of files, cad)

Other CAD files:
output/v3/CNC_v3.step
output/v3/CNC_v3_r5.FCStd
output/v3/CNC_v3_r6.FCStd
output/v3/CNC_v3.FCStd
