arco651749/CNC-DESIGN/(commit log)

2026-11-12 Add gantry CNC v1 layout model, coolant system and GA drawing
    [CNC_Gantry.FCStd, CNC_Gantry.step]
2026-11-12 Rebuild model in CadQuery as v2: servo belt spindle, DFU screws, Mitsubishi servos
    - cad/cnc_gantry.py: CadQuery port of the parametric layout model with v2 design
    (HG-KR43 x5, ER11 belt spindle 1:3, DFU lead-5 screws, ZA rail blocks, BK/BF
    supports, couplings, electrical cabinet); fixes column/rail and Z-plate clashes
    - cad/make_drawing.py: GA drawing via OpenCascade HLR (no FreeCAD needed)
    - regenerate output STEP, cnc_info.json and GA SVG; move v1 FCStd to output/v1
    Claude-Session: https://claude.ai/code/session_013qHaQ5tGPE7u3XPh9aofnH
    [CNC_Gantry.step, CNC_Gantry_v1.FCStd]
2026-11-12 Model ER11 nose (collet, nut, spindle nose, D5/D6 tool) and add spindle detail drawing
    - cnc_gantry.py: ER11 collet (8 deg taper, 30 deg front), type-A nut with wrench
    slots, M13 spindle nose, D5 end mill on D6 shank; cartridge bore for collet
    - make_spindle_detail.py: A3 sheet with spindle head front 1:2, belt drive top 1:2
    and hatched ER11 nose section 2:1 plus ER11 spec table
    - regenerate STEP, cnc_info.json, GA SVG; README updated
    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
    [CNC_Gantry.step]
2026-11-12 Fix Y travel: spindle must reach the whole 300 mm work area
    v1 placed the machining position at the end of the 600 mm stroke (table centre
    +120), so the front 150 mm of the work area was unreachable and the loading
    position (-480) crushed the front bellows. Table centre now runs +270 (spindle at
    work-area front edge) .. -30 (rear edge) for machining and -330 for loading,
    still 600 mm total. Swept the table to both ends: no clashes, blocks stay on rail.
    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
    [CNC_Gantry.step]
2026-11-12 Compact layout: Y travel 400, rear Y motor, cabinet on gantry back
    - Y travel 600 -> 400 (machining 300 + loading 100: work area just clears the
    spindle head); bed length now derived from the stroke with bellows kept at
    >=15 % compressed (1400 -> 1065), Y rails 1200 -> 760
    - Y motor + BK15 moved to the rear, BF15 in front; rear guard cut-out
    - columns 140 -> 100 wide, bed width = beam length so columns sit on the bed
    - coolant troughs moved outside the bed (fixes v1 trough/bed overlap), guards
    outside the troughs; drain routed behind the stand
    - electrical cabinet shrunk to 480x300x200 and hung on the gantry back; FRL on
    the left column back; coolant hose re-routed
    - overall 1220x154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
    [CNC_Gantry.step]
2026-11-12 Narrow gantry to just clear the 440 mm table
    The spindle head runs in front of the beam (Y <= 286) while the columns sit
    behind the beam front face (Y >= 298), so the column span only has to clear the
    moving table, not the head travel. Span 632 -> 480 (table 440 + 2x20), bed and
    beam 832 -> 680, X rails 640. Coolant tank narrowed to 500 (~99 L) to fit
    between the legs; drain and coolant riser re-routed clear of the legs; cabinet
    440 wide behind the columns. Overall 1012 -> 860 wide. Full X/Y/Z extremes
    swept clash-free.
    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
    [CNC_Gantry.step]
2026-11-12 Drop the electrical cabinet: drives and controller on the beam rear face
    4x MR-J4-40A + Teensy/T41U5XBB + PSU + breaker fit a 440x260 plate bolted to
    the gantry beam rear between the columns, under a thin vented sheet cover
    (Al chips are conductive, 220 V terminals). No clashes.
    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
    [CNC_Gantry.step]
2026-11-12 Switch spindle to 0.8 kW air-cooled electro-spindle (D65, ER11, 24,000 rpm)
    - remove spindle servo, pulleys, belt, guard and motor bracket; add D65 x 188
    air-cooled spindle with fan cover and aviation plug, D65 split Al clamp;
    Z slide plate narrowed; tool tip height unchanged
    - electrics: 3x MR-J4-40A + spindle VFD on the beam rear panel
    - GA and spindle detail drawings updated (detail: front + top 1:2, ER11 2:1)
    - static and full-travel clash checks pass
    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
    [CNC_Gantry.step]
2026-11-12 Inverted Y guide: rails under the table, blocks fixed on one machined pad
    - Y rails (HGR25 L=620) on 50x20 carrier bars under the table, moving with it;
    4 HGH25CA blocks fixed at Y=10/130 right under the machining zone; rail
    length chosen so both blocks stay engaged over the full 400 mm stroke
    - full-length t30 machined bed top replaced by a t3 SUS304 floor/coolant tray;
    only the 400x240 block pad needs precision machining, plus column and
    screw-support seats
    - screw axis raised, nut hangs under the table; bellows narrowed to cover the
    screw only; table top 940 -> 960 (beam raised, clearance unchanged)
    - static and full-travel clash checks pass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
    [CNC_Gantry.step]
2026-11-12 Y blocks straddle the spindle; single datum base plate for columns + blocks
    - fixed Y block rows at spindle_y -/+ 60 (60 / 180) so the cutting force sits
    between them; 620 mm rails offset rearwards to stay engaged at both ends
    - block pad and column pads merged into one datum base plate (680 x 528) so
    column seats and block seats are milled in one setup
    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
    [CNC_Gantry.step]
2026-11-12 Short Y screw: BF/BK and Y motor on the datum plate
    - Y screw 1070 -> 595 mm: BF15/BK15 placed right at the nut stroke ends, motor
    coupled directly behind BK15, all seated on the (extended) datum base plate
    - rail carrier 20 -> 30 so the 60 mm motor fits under the table with 5 mm
    clearance top and bottom; screw axis at plate + 35
    - way covers ride at table height over the supports and motor
    - rear motor overhang gone: overall depth 1205 -> 1123
    - static, Y, X/Z sweep checks pass (nut stops 10 mm from each support)
    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
    [CNC_Gantry.step]
2026-11-12 Trim Y screw to 565 mm (thread 500 = stroke 400 + nut 90 + 2x5)
    Nut housing 110 -> 90 (DFU2005 double nut ~80-90 long), nut-to-support gap
    10 -> 5. Remaining length is only the BF/BK journals and the coupling end.
    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
    [CNC_Gantry.step]
2026-11-12 Replace Y bellows with a fixed screw tunnel; shorten bed
    - fixed inverted-U SUS304 tunnel over the Y screw (BF15 -> BK15) on the datum
    plate, 16 mm top slot with brush seals; nut block runs inside, a t10 neck
    plate passes the slot to the table; bellows removed
    - without bellows the bed only needs the table/rail sweep: 1065 -> 1010,
    overall depth 1123 -> 1068
    - static, Y, X/Z sweep checks pass
    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
    [CNC_Gantry.step]
2026-11-12 Remove the Y screw tunnel for now (protection decision deferred)
    Nut seat back to a single block bolted under the table.
    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
    [CNC_Gantry.step]
2026-11-12 Y screw shifted rearwards: BK15 on the datum-plate rear edge, motor overhangs
    Nut seat mounted 153 mm behind the table centre (still under the table), so
    the whole 565 mm screw moves back: BK15 flush with the column rear face and the
    Y motor hangs out behind the datum plate. Datum plate 718 -> 565 mm long.
    Nut keeps 5 mm to BF/BK at the stroke ends; sweeps clash-free.
    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
    [CNC_Gantry.step]
2026-11-12 Inverted Y screw: nut fixed under the spindle, screw and motor ride with the table
    - DFU2005 nut seat fixed on the datum plate at Y=120 (between the block rows,
    right under the spindle); 565 mm screw with BF15/BK15 bolted under the table
    - Y motor hangs under the table beside the screw, 1:1 HTD 5M belt (direct
    coupling would stick out of the machine); motor cables in a flat drag chain
    - datum plate now only carries block, nut and column seats: 680 x 498
    - Y sweep: blocks engaged, nut keeps 5 mm to the thread ends, no clashes
    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
    [CNC_Gantry.step]
2026-11-12 Y: L-shaped motor bracket on the table rear edge, fixed-free DFU1605, no rail spacers
    - Y motor direct-coupled on an L-shaped bracket (top flange on the table top,
    leg on the rear face) with the fixed-end bearing pair built into the leg; no
    separate BK/BF supports, screw front end free (fixed-free; ~1.4k rpm critical
    speed margin vs 1.2k rpm needed)
    - Y screw DFU2005 -> DFU1605 (same as X/Z), axis lowered to plate + 11; fixed
    nut flange sits in a 15 mm pocket of the datum plate; 120 mm slot in the
    plate for the bracket/motor path
    - rail carrier spacers removed: HGR25 bolted straight under the table, table
    top back to 940
    - nut fixed at Y=25 so the thread ends inside the table; be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
    [CNC_Gantry.step]
2026-11-12 Y guides HG25 -> HG35 (H=55): screw axis and Y motor above the datum plate
    With 55 mm under the table the fixed DFU1605 nut seat (truncated flange,
    38 thick) and the 60 mm Y motor both clear by 3 mm, so the datum plate is a
    flat plate again (no motor slot, no nut pocket) and no rail spacers are needed.
    Rails 640 mm (longer HGH35CA blocks). Table top 955; all sweeps clash-free.
    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
    [CNC_Gantry.step]
2026-11-12 Aluminium-extrusion gantry (MISUMI HFS8-80160) and core-assembly export
    - gantry columns: HFS8-80160 upright on 15 mm foot plates; beam: two
    HFS8-80160 side by side (160x160) sitting on the columns, tied by 12 mm
    joint plates; 15 mm milled steel plate on the beam front as X rail datum
    - X rails re-spaced for the 160 mm beam; support units shortened
    - cad/core_assembly.py: datum plate + Y axis + gantry + X/Z + spindle only (no
    base) -> output/core/CNC_Core.step and CNC_Core_BOM.csv with sourcing
    (MISUMI / HIWIN / Mitsubishi / machined) and open part-number items
    - all sweeps clash-free
    Claude-Session: https://claude.ai/code/sess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
    [CNC_Core.step, CNC_Core_BOM.csv, CNC_Gantry.step]
2026-11-12 GA spec block: note the MISUMI extrusion gantry
    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
2026-11-12 Add text-to-cad skills (cad, fea, engineering-drawing) and setup notes
    Vendored from earthtojake/text-to-cad (MIT, license included). The tool runs in
    an isolated venv (/opt/ttc) because its OCP 8.0 conflicts with CadQuery's 7.9;
    telemetry and auto-update turned off. Smoke-tested on output/core/CNC_Core.step:
    inspect reads all 60 parts; interference reports only the intended screw /
    nut / support / coupling fits.
    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
    [CNC_Gantry.step]
2026-11-12 v3 FreeCAD assembly with MISUMI / Mitsubishi vendor parts, bed removed
    - assemble_v3.py: places vendor STEP (HFS8 extrusions, SX28/SE42 guides,
    C-KBS1505 screws, C-TEK12/C-TEF12, CPJC40 couplings, HG-KR43(B),
    MR-J4-40A) on the datum plate; spindle modelled from spec
    - Y rail SE2RZ42-680, screws X 540 / Y 545 / Z 330, Z fixed-free
    - static interference: none; travel-end sweep: no collisions
    - BOM, 4-view SVG, check reports; vendor CAD and outputs embedding it
    are git-ignored (vendor terms of use)
    [CNC_v3_BOM.csv]
2026-11-13 v3 r6: motor blocks on the base faces (X/Y/Z same way), MISUMI C-HLG45 Y guide, Z assembly +100, datum 640x512
    - freecad/revisions/01..07: reproducible v3 -> r6 chain + collision sweep (none)
    - vendor models (MISUMI C-HLG45-700, Mitsubishi HG-KR43/43B/J) and FCStd/STEP outputs added at the owner's request
    - output/v3/CNC_motion_r6.html: 3D motion viewer; R6_CHANGES.md: change log and BOM delta
    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
    [CNC_v3.FCStd, CNC_v3.step, CNC_v3_fix.FCStd, CNC_v3_r2.FCStd, CNC_v3_r3.FCStd, CNC_v3_r4.FCStd, CNC_v3_r5.FCStd, CNC_v3_r6.FCStd]
2026-11-13 r7: remove the X floating support C-TEF12 (all three screws fixed-free)
    Critical speed check: fixed-free, root ~12.5, L ~450 -> ~2100 rpm (x0.8 = 1680) > 1200 rpm at 100 mm/s.
    The Y front assembly is the fixed ball nut + nut seat of the inverted screw and stays.
    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
    [CNC_v3_r7.FCStd]
2026-11-13 v4: X through-slot drive behind a t20 X base plate (gantry beam), columns forward, datum t20
    - freecad/v4/01: builds output/v4/CNC_v4.FCStd from v3 r7 (r7 frozen, untouched)
    - freecad/v4/02: 18-pose collision sweep (none) + clearances
    - X motor folded under the screw with a 1:1 HTD5M belt; beams and joint plates removed
    - output/v4/CNC_motion_v4.html, renders, V4_NOTES.md
    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
    [CNC_v4.FCStd]
2026-11-13 v4: X direct drive (CPJC40) behind the plate, CNC nut housing wrapping the ball nut through the slot
    - belt fold removed; X motor in line, plate rear gets a 7 mm locating pocket for the motor block
    - nut housing wraps the C-KBS1505 nut body, flange on its +x face; slot 347x72
    - sweep: no collisions (output/v4/logs)
    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
    [CNC_v4.FCStd]
2026-11-13 v4: nut housing same size as the nut flange, slot 347x60; refreshed 3D page (CNC_motion_v4_direct.html)
    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
    [CNC_v4.FCStd]
2026-11-13 v4: Y and Z nut housings wrap the ball nut like X; static all-pairs check added
    - Y nut housing bolted down into the datum plate (nut moved back 26 to sit on the plate)
    - Z nut housing bolted to the slide rear face, flange on top
    - 02_motion_check_v4 now also checks every pair at rest (parts that move together were skipped before); none
    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
    [CNC_v4.FCStd]
2026-11-13 v4: motor seats bored D50 H7 straight through = HG-KR43(B) spigot D50x3 (measured from the Mitsubishi STEP)
    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
    [CNC_v4.FCStd]
2026-11-13 v4: ball screws with real end machining into the C-TEK12 (D12 bearing + D10 coupling), fake journals removed
    - Y thread extended to the support face: nut stays on the thread over the full travel (was 29 mm off at the loading position)
    - couplings CPJC40-RD-10-14; check reports thread engagement per axis
    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
    [CNC_v4.FCStd]
2026-11-13 Stop tracking vendor/ (MISUMI / Mitsubishi CAD, kept local only)
    Files stay on disk and are git-ignored. Removing from tracking only;
    history is not rewritten.
2026-11-13 Track STEP files (MISUMI / Mitsubishi vendor parts and generated STEP)
    Vendor STEP under vendor/ and output STEP are now versioned, per user
    request. FCStd documents remain git-ignored.
    [CNC_v3-AP214.step]
2026-11-13 v4: MISUMI screw shafts, motion page fix, X base plate FEA
    - 01_v4_through_slot_x.py: X/Y/Z screws use the MISUMI C-KBS1505-458/538/393
    vendor shafts (cut at the C-TEK12 face, D12/D10 ends fused on)
    - export_motion_html.py: rebuild the motion page DATA from CNC_v4.FCStd;
    match parts by label so Z_motor_plate moves with X again
    - fea/: CalculiX linear static of the X base plate t20 (moving head 53 kg,
    4 cases) + interactive results page X_base_plate_FEA.html
    - gitignore FEA intermediates and vendor download zips
    [CNC_v4.FCStd, x_base_plate.step]
2026-11-13 v5-v9 layout studies: saddle box beam, taller X plate, lower rail and drive
    - v5: saddle over a box beam, front + rear X rail (feasibility only)
    - v6: from v4, plate down to z280, lower rail z300, X drive axis z350
    - v7: plate height +50% (315 mm)
    - v8: lower rail z195 (spacing 275), carriage to z167, drive axis z245
    - v9: plate bottom = highest tool tip (z230), lower rail z250 (spacing 220),
    carriage z222, drive axis z300
    - each: build script, travel-end collision sweep (0 collisions), motion page
    with spin pivots read from the model
    - FEA: CG reference-node coupling check (matches hand loads within 1%)
    - .claude/launch.json: local preview of output/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
2026-11-13 v10: X drive moved to the neutral line midway between the X rails (z360)
    - screw thrust adds no pitching moment on the carriage; the Z-head moment stays on the rails
    - slot + motor pocket follow; nut housing now 63 mm from the lower blocks (v9: 3.6)
    - sweep: 0 collisions at the travel ends; motion page output/v10/CNC_motion_v10.html
    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
2026-11-13 v10: X base plate FEA (CalculiX, same model as v4)
    - freecad/v10/fea/01..03: export plate + head mass/CG + gmsh mesh, 4 load cases, results page
    - head 55.9 kg; weight case: tool-tip Y offset 14 um (v4: 67), head tilt 78 urad (v4: 291), max 2.9 MPa
    - weight + 100 N tool force: 23 um (v4: 113)
    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
    [x_base_plate.step]
2026-11-13 v10 frame FEA scripts: plate + HFS8 columns + feet, conformal gmsh mesh, ccx iterative solve
    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
2026-11-13 v10 frame FEA: mesh dir / size / 3D algorithm and solver selectable by env (FRAME_DIR, CLMAX, CLMIN, ALGO3D, SOLVER)
    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
2026-11-13 v10 frame FEA: equivalent-tube column option (Ixx/Iyy = MISUMI HFS8-80160), defeaturing option, SPOOLES
    The real profile meshes to ~2.3 M dof (thin 2-3 mm walls; fillet removal does not reduce it), too big for a
    direct solve in 16 GB; the iterative run did not finish. Columns as an 80x160 tube with walls 5.787 / 7.677 mm
    match both bending inertias exactly; density scaled to keep the profile mass.
    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
2026-11-13 v10 frame FEA results: plate + equivalent HFS8 columns + feet
    - tool-tip Y offset (weight) 16.4 um vs 14.0 um plate-only; weight + 100 N: 30.9 vs 23.0 um; x+150: 8.3 vs 5.7 um
    - head tilt 91 urad (plate-only 78); column max 2.4 MPa
    - results page output/v10/fea/X_plate_columns_FEA.html (06_frame_html.py)
    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
2026-11-13 v10: alignment plan for parallelism and squareness
    Procedure, tools, measurement methods and proposed adjustment
    features (reference shoulders, push blocks, shimmed feet,
    match-reamed dowels) for assembling and verifying the v10 gantry.
    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
2026-11-13 v10 alignment plan: push blocks at foot front only; pin decision recorded
    The datum plate ends flush with the foot rear, so yaw is adjusted by
    pushing either column backward from the front. X plate to column dowels
    go in the solid corners of the extrusion.
    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
2026-11-13 v10: alignment animation page; plan updated for fixture plate and foot flange
    Nine animated steps on the v10 model: rail parallelism, X-Y squareness
    measure and adjust, Z squareness measure and adjust, dowelling, spindle
    to Z, fixture-plate skim cut. Building it showed three things the plan
    had wrong for v10: the tool cannot reach the table (skim a fixture
    plate instead), a test bar allows about 60 mm of Z travel, and the feet
    need a front flange for bolts, dowels and push blocks.
    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
2026-11-14 v11: adjusters for every alignment (from v10, frozen)
    Feet with a front flange, jack screws, hold-down bolts and yaw push
    blocks; X level jacks under the X base plate; carriage split into a
    saddle and a Z plate with a pivot pin and opposed push screws; long
    ears on the spindle clamp with jack and push screws; reference pins,
    eccentric pins and side screws for the rails; match-reamed dowels;
    fixture plate and indicator holder. 126 new parts, holes cut in the
    parents. Collision sweep over the 8 travel-end poses: 0 collisions.
    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
2026-11-14 v11: three-layer adjusters with wedges; spindle 3-point carrier; v11 alignment procedure
    Layer 1 feet: 1:10 wedge under each foot flange (M5x0.5 from the outer
    side, 6.7 urad per 10 deg), 10 mm pivot rib at the rear, yaw push-pull.
    Layer 2 Z plate pivot unchanged. Layer 3 spindle clamp rebuilt as a
    3-point carrier: crowned bar, 1:20 nod wedge set at final bolt preload
    (disc springs), D8 roll pin on the bar line, 1:15 side wedge; spindle
    axis moved 13 mm forward, fixture plate follows. X level jacks and the
    offset indicator holder removed; rail side screws moved opposite the
    pins. New procedure replaces the v10 plan and fixes the review findings
    (early skim, indicator on the spindle axis, col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
2026-11-14 v11: motion simulation page (v10 viewer, v11 model, work piece on the fixture plate)
    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
2026-11-14 v11: removable alignment kit
    Everything that only pushes is a bolt-on module that comes off after the
    joint is torqued and dowelled and is reused on the next machine (39
    parts: yaw push-pull blocks, foot-wedge drives, Z-tram push blocks,
    spindle roll wedge and follower, spindle nod drive). Load-carrying parts
    stay: foot wedges, nod wedge pair, crowned bar, pins. Tour page gets a
    kit on/off toggle; the motion page shows the production state. Design
    note explains why X has no separate adjuster.
    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
2026-11-14 v11: foot pitch by ground shims instead of wedges
    Each foot flange stands on a U-slotted ground shim pack (nominal 0.5);
    0.01 mm of shim is 53 urad. A removable M8x1 jack screw (alignment kit)
    lifts the flange to change shims. The procedure computes the shim
    change directly from the measured column lean (x 1.9). Wedge seat,
    wedge and wedge drives removed. Collision sweep: 0 collisions.
    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
2026-11-14 v12 (from v10): owner's alignment architecture, first model
    Y is the datum (pins). Gantry turns on a pivot pin in the left foot and
    is pushed at the right foot (X perp Y). X plate turns on a pin in the
    left column and is lifted by a jack at the right (X level); it stands
    1 mm off the columns and is frozen by 8 injected epoxy pads. Saddle and
    Z plate meet only through a D12 ball; two face screws and opposed side
    screws set the Z axis, then 6 epoxy pads freeze it. Spindle preset to
    the Z rails on 4 shim packs with a roll pivot; axis moved to y-8.
    Push-only parts form a removable kit.
    Claude-Session: https://claude.ai/code/session_013qHaQ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
2026-11-14 v12: standalone page for the Z-plate ball joint
    Saddle, Z plate, D12 ball, face screws, side screws, clamp bolts and
    epoxy pads on their own, with an exploded view, a section through the
    ball and the three adjustment motions about the ball.
    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
2026-11-14 v12: Z-plate ball moved to the plate centre; differential adjusting screws
    The ball now sits at the centre of the Z plate (z466), so the plate tilts
    symmetrically either way (+-4.1 mrad before an edge meets the saddle).
    The shorter levers (234 face, 214 side) are compensated by differential
    screws (M8x0.75 / M6x0.5 = 0.25 mm/rev): about 30 urad per 10 deg.
    Collision sweep: 0 collisions.
    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
    [01_v12_adjusters.py]
2026-11-14 v12: Z-plate pivot is a MISUMI RBPB8 spherical bearing (vendor STEP)
    The loose ball is replaced by an RBPB8 pressed into the centre of the
    saddle, with a D8 pin pressed into the Z plate and slide-fitted in the
    inner ring, so the bearing fixes X and Z but never takes the Y thrust.
    A third differential face screw at the bottom centre holds Y together
    with the two top screws (gap, nod, turn about Z). Vendor STEP added
    under vendor/misumi/RBPB8. Collision sweep: 0 collisions.
    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
    [01_v12_adjusters.py, 04_export_motion_html_v12.py, 05_export_ztram_html_v12.py]
2026-11-14 v12: spindle clamp on the same RBPB8 pivot, fixed by shims
    RBPB8 pressed into the Z slide under the left ear, D8 pin in the ear
    (slide fit, no thrust). Three differential face screws through the ears
    set the 2 mm gap and nod, opposed differential side screws set roll;
    the result is fixed by ground shim packs at the 4 bolts so the layer
    stays re-adjustable. Spindles are to be screened at goods-in for
    housing-to-axis error. Collision sweep: 0 collisions.
    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
    [01_v12_adjusters.py, 04_export_motion_html_v12.py]
